SDLLABS/LoonIntercom/docs/images/intercom-render.jpg

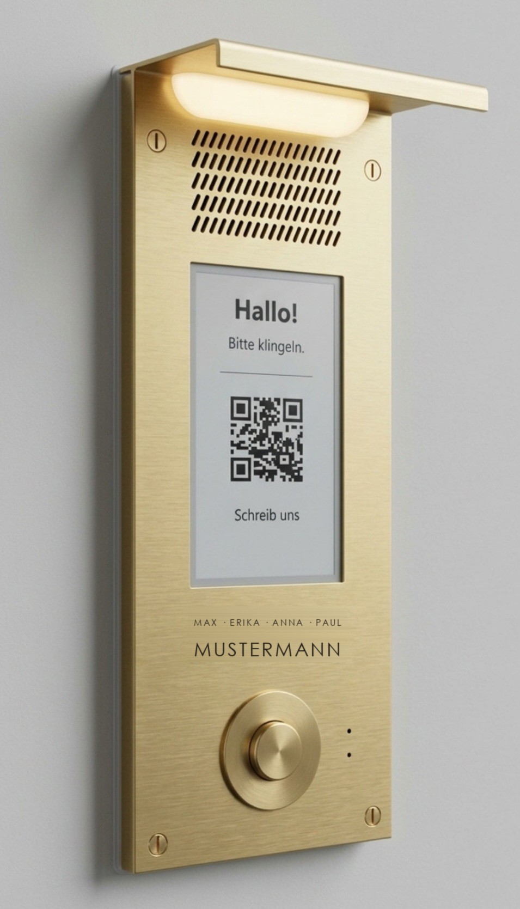
docs/images/intercom-render.jpg
