SDLLABS/LoonIntercom/hardware/access-controller/README.md

# Indoor controller hardware gates

No board, schematic or actuator is selected by WP4. All switching and strike/gate power paths must stay in a protected indoor enclosure. No outdoor conductor may energize an actuator when shorted. A P4-connected keypad remains an observable convenience input; a possible high-assurance keypad needs a separate protected connection directly to the indoor controller.

Before connecting a real actuator, select and verify: protected indoor resource-to-actuator and timing profiles; default-off drive for **every** relay and boot/reset/brownout pull state; an **independent** maximum-on cutoff that drops output after its armed bound even if MCU firmware stalls; a `force_cutoff_off` path that physically removes actuator power even when relay-off fails; a `force_relays_off` path for all outputs; fail-secure polarity and power behavior; door contact plus held-open/forced-open sensing; protected REX and egress/fire compliance; key storage and provisioning; tamper response that cannot unlock; surge/power isolation. Production pulse/cutoff values remain unselected. A welded relay contact may bypass an electrical cutoff and needs separate hazard review. The software API callbacks are contracts, not evidence of such circuitry.
