SDLLABS/LoonIntercom/firmware/access-controller/README.md

# Indoor access controller skeleton

`access_core.c` is a portable, allocation-free verifier, attempt limiter and relay state machine for WP4. It contains no board-specific relay pin, network listener, credential database or secret. `access_core.h` defines adapters that a future protected indoor MCU implementation must provide. Protected indoor policy maps each authenticated resource ID to an actuator ID and pulse/cutoff profile; the credential adapter must check that resource's scope. The `force_cutoff_off` adapter must force the independent power cutoff safe even if the relay driver cannot deassert; `force_relays_off` must de-energize every output at boot/fault. Neither may bypass or disable the safety cutoff. Until then this is **host-testable design code, not deployable access-control firmware**.

Run `make test` for the host tests. The test harness uses OpenSSL only to model a HMAC provider; the product crypto/transport adapter is not selected. The core requires a trusted authenticated confidential-channel assertion and a per-principal MAC verifier. It cannot be called safely from a raw UDP/MQTT handler. The caller must wipe sensitive receive buffers after dispatch, ensure transport identity equals `principal_id`, and serialize controller calls.

The P4 keypad path is restricted to scoped convenience credentials. A higher-assurance keypad needs its own protected direct path indoors. No keypad hardware is selected. The transport must supply its authenticated peer ID to both core entry points; the core checks that a request frame names the same principal. See [protocol](../../protocol/access.md) and [hardware gates](../../hardware/access-controller/README.md).

The host test's 250 ms pulse and 500 ms cutoff are illustrative skeleton profile values, not production settings. Compile-time ceilings and runtime profile checks reject unsafe values, but hardware must independently enforce maximum-on. A one-time credential is consumed by the indoor adapter upon authorization before hardware actuation; a later hardware failure does not refund it or prove door movement.

## SMS one-time-code path (ADR-0005)

`sms_parse.c` strictly parses an `ABRIR <resource> <code>` body, `sms_otp.c` computes and verifies LSMS1 counter-based codes (HMAC-SHA-256 bound to resource and command, 20-value look-ahead, constant-time), and `ac_handle_sms()` applies the same attempt limit, lockout, busy and actuator-profile checks as ACR1 before the code is checked, so refused attempts never consume a counter. The `verify_sms_otp` callback is optional; `NULL` disables the path. The adapter must map an allowlisted sender to an `AC_PRINCIPAL_GSM` principal and persist `matched + 1` before returning true. See [protocol/sms-access.md](../../protocol/sms-access.md) and `tools/loon_sms.py` for the phone side.
