SDLLABS/LoonIntercom/docs/upstream-map.md

# Upstream feature and provenance map

Snapshot: 2026-10-01. Inspected local SDLLABS branch `3e56b7d5cda3cb52aa66ff9235040faf1f77c6e9`, remote [SDLLABS `main`](https://github.com/SDLLABS/intercom/tree/77b56da677b08da73ba137dddba78e8834585f59) and [Aikos `main`](https://github.com/aikos-home/intercom/tree/77b56da677b08da73ba137dddba78e8834585f59) at the same commit, and [OpenChime `main`](https://github.com/exddc/openchime/tree/8085381252216dccae1ad18aaa766daee0c03c6c). Remote heads were checked with `git ls-remote`; OpenChime was shallow-cloned to a temporary directory for inspection. This map distinguishes implemented code from specifications and proposals. No OpenChime source was imported.

| Feature or lesson | Current source and evidence | Current maturity | SDLLABS treatment |
| --- | --- | --- | --- |
| Supervised physical button, 1 ms ADC sampling intent, hysteresis, press identity, cable-cut/short diagnostics, maximum ring duration | [Aikos bell core](https://github.com/aikos-home/intercom/blob/77b56da677b08da73ba137dddba78e8834585f59/firmware/bell/bell-core.yaml); [bench notes](https://github.com/aikos-home/intercom/blob/77b56da677b08da73ba137dddba78e8834585f59/firmware/bell/README.md) | Implemented in inherited ESPHome configuration; bench results documented, not re-tested in WP1 | Preserve in `firmware/bell/`; regression gate for later changes. |
| Direct RoomKey ring: encrypted UDP `packet_transport`, rolling code, `(boot_id, presses)` identity, `ringing` state, unicast targets | [Bell core](https://github.com/aikos-home/intercom/blob/77b56da677b08da73ba137dddba78e8834585f59/firmware/bell/bell-core.yaml), [S3 board config](https://github.com/aikos-home/intercom/blob/77b56da677b08da73ba137dddba78e8834585f59/firmware/bell/s3poeeth-intercom-bell.yaml), [bell README](https://github.com/aikos-home/intercom/blob/77b56da677b08da73ba137dddba78e8834585f59/firmware/bell/README.md) | Implemented bell sender; RoomKey receiver belongs to separate Aikos project and was not inspected here | Keep direct path and test with RoomKey later. HA API remains secondary and has `reboot_timeout: 0s`, `batch_delay: 0ms`. |
| E-paper/touch UI and partial-refresh driver | [Screen firmware](https://github.com/aikos-home/intercom/tree/77b56da677b08da73ba137dddba78e8834585f59/firmware/screen), [screen README](https://github.com/aikos-home/intercom/blob/77b56da677b08da73ba137dddba78e8834585f59/firmware/screen/README.md) | Bench-tested inherited screen subsystem; driver states LilyGo/ESPHome provenance and C/C++ GPLv3, Python MIT | Retain as separate failure domain. Review compatibility and licenses before integrating into a new image. |
| PoE, surge, heater fail-cold, environmental/mechanical design and power governor | [Inherited architecture](https://github.com/aikos-home/intercom/blob/77b56da677b08da73ba137dddba78e8834585f59/docs/architecture.md), [hardware tree](https://github.com/aikos-home/intercom/tree/77b56da677b08da73ba137dddba78e8834585f59/hardware) | Mixed: documented design, components/bench work, and unverified installation choices | Preserve safety rules; recompute P4 power/thermal margin rather than assuming existing PoE budget covers camera/audio. |
| Chime MQTT-to-audio service, reconnect/heartbeat, independent HTTPS setup daemon | [OpenChime Chime README](https://github.com/exddc/openchime/blob/8085381252216dccae1ad18aaa766daee0c03c6c/chime/README.md), [source tree](https://github.com/exddc/openchime/tree/8085381252216dccae1ad18aaa766daee0c03c6c/chime) | Implemented for Pi Zero W and Linux, with host tests; depends on broker for Chime ring | Learn service/config separation and observability. Do not replace Aikos direct RoomKey path with broker-dependent Chime. |
| Product/platform/board dependency direction, bounded process work, separate configuration runtime | [OpenChime platform README](https://github.com/exddc/openchime/blob/8085381252216dccae1ad18aaa766daee0c03c6c/platform/README.md) | Implemented C++/CMake structure with Linux/POSIX services | Adapt the interface-boundary principle to ESP-IDF components; do not copy POSIX runners, filesystem/HTTP server infrastructure by default. |
| WebRTC, Opus, hardware H.264, full duplex/AEC and MQTT signaling | [OpenChime Ring variant requirements](https://github.com/exddc/openchime/blob/8085381252216dccae1ad18aaa766daee0c03c6c/hardware/ring/variants/rpi02w_cm3/README.md) | **Specification only in current Ring tree** (`ring/README.md` is a placeholder); Pi hardware assumptions differ from P4 | WP3 feasibility study, then select ESP-IDF-compatible implementations. No assertion that OpenChime provides portable working media code. |
| Signed command plus nonce; BLE challenge/counter; Ring MQTT status/press topics | [OpenChime Ring variant requirements](https://github.com/exddc/openchime/blob/8085381252216dccae1ad18aaa766daee0c03c6c/hardware/ring/variants/rpi02w_cm3/README.md) | Ring interface requirement, not an implemented, reviewed access protocol | Borrow threat questions only. WP4 designs a separate indoor-verifying protocol; no outdoor relay command topic. |
| Outdoor strike/gate relays and Pi/SD/Buildroot image | [OpenChime Ring wiring/interface](https://github.com/exddc/openchime/blob/8085381252216dccae1ad18aaa766daee0c03c6c/hardware/ring/variants/rpi02w_cm3/README.md), [Buildroot tree](https://github.com/exddc/openchime/tree/8085381252216dccae1ad18aaa766daee0c03c6c/buildroot) | Ring hardware design and implemented Chime Linux image/OTA model | Explicitly reject relay placement, Pi drivers, Buildroot, SD boot/rootfs. Adapt only rollback and runbook ideas to NOR/ESP-IDF. |
| Local-only operation and hardware documentation discipline | [OpenChime README](https://github.com/exddc/openchime/blob/8085381252216dccae1ad18aaa766daee0c03c6c/README.md), [Ring hardware README](https://github.com/exddc/openchime/blob/8085381252216dccae1ad18aaa766daee0c03c6c/hardware/ring/README.md) | Project design/documentation | Use as engineering references, with SDLLABS trust and power boundaries. |

## Target silicon evidence

Espressif's [ESP32-P4 Series datasheet, section 4.2.1](https://www.espressif.com/sites/default/files/documentation/esp32-p4_datasheet_en.pdf) documents a Baseline H.264 hardware encoder with maximum 1080p30 performance for YUV420 input, plus MIPI-CSI and an ISP. This is an established SoC capability, not an OpenChime port or proof that a selected board, sensor/driver, PSRAM, NOR, Ethernet/PoE and audio combination works. WP2 validates those board paths and capture/encode; WP3 evaluates complete streams, RTSP/WebRTC, Opus/AEC, latency and memory/CPU/network budgets.

## Provenance and license rules

The current SDLLABS `main` remains at the Aikos commit above; this branch adds handoff/architecture material and WP1 docs. Existing Aikos bell and screen code stays in place. OpenChime is [MIT licensed](https://github.com/exddc/openchime/blob/8085381252216dccae1ad18aaa766daee0c03c6c/LICENSE); no code was copied for WP1. A future port must record upstream repository, commit, source path, copied/adapted files, modification summary, and applicable copyright/license notices in the change and retain the MIT notice where required. Third-party code nested inside OpenChime needs its own license audit. The existing screen driver has separate [license information](https://github.com/aikos-home/intercom/blob/77b56da677b08da73ba137dddba78e8834585f59/firmware/screen/components/lilygo_t5_47_plus/LICENSE).

## Baseline reconciliation

The inherited `docs/architecture.md` says the ring goes to HA first and rules out cameras. Those statements describe an earlier Aikos product concept. The current bell implementation sends a direct RoomKey packet independently of HA, and SDLLABS v2 adds a separate P4 camera subsystem while leaving the bell path intact. Do not rewrite the inherited historical document as evidence of v2 implementation. See [architecture v2](architecture-v2.md) and its ADRs for the adopted direction.
