SDLLABS/LoonIntercom/docs/images/explorer.png

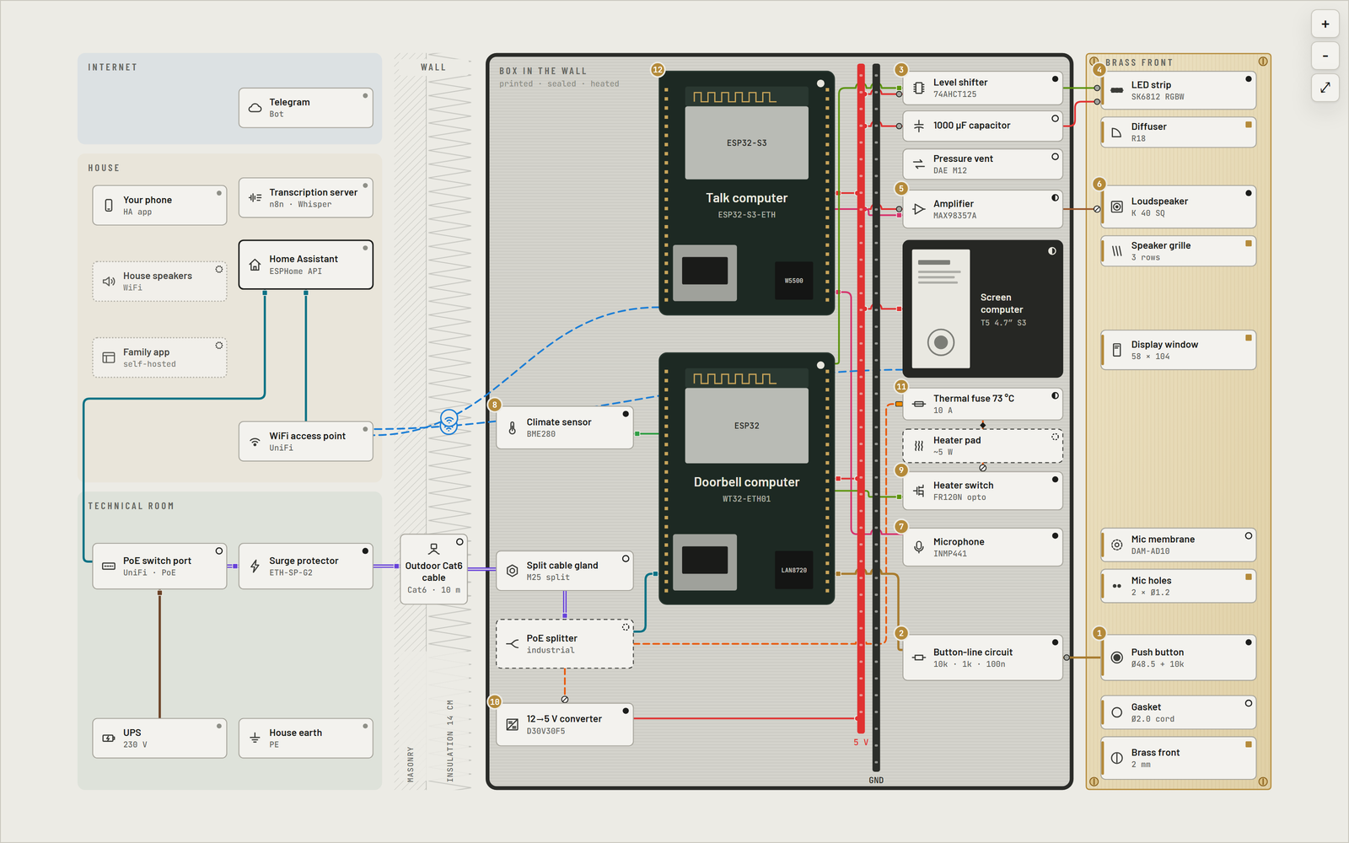
docs/images/explorer.png
