SDLLABS/LoonIntercom/firmware/screen/demo-assets/bell.gif

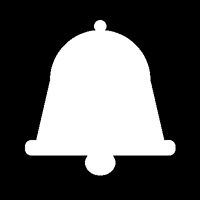
firmware/screen/demo-assets/bell.gif
