SDLLABS/LoonIntercom/firmware/screen/demo-assets/front.png

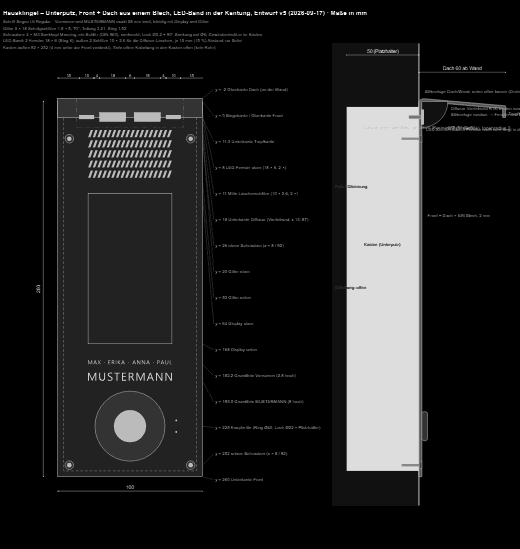
firmware/screen/demo-assets/front.png
