SDLLABS/LoonIntercom/hardware/front-sheet/detail-kantung-v5.png

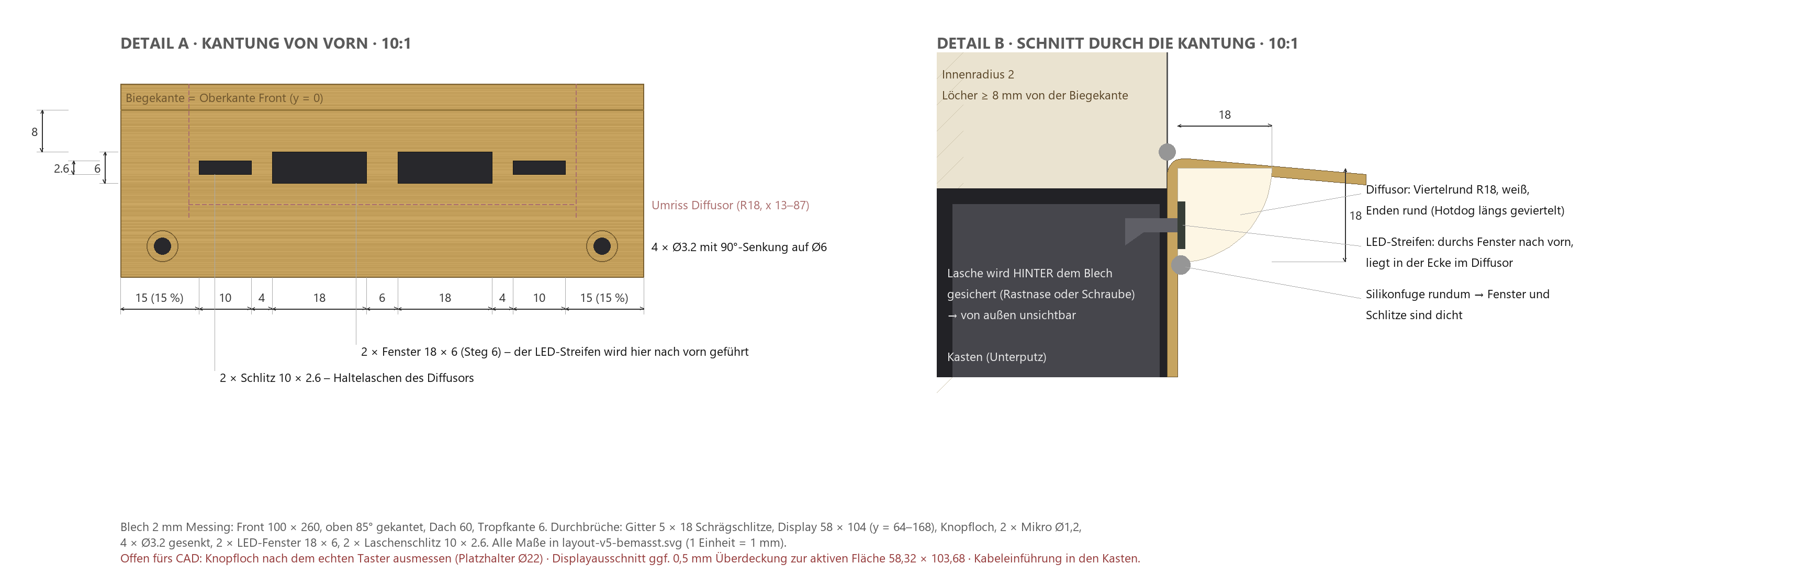
hardware/front-sheet/detail-kantung-v5.png
