SDLLABS/LoonIntercom/hardware/front-sheet/gemini-zeichnung-v5.png

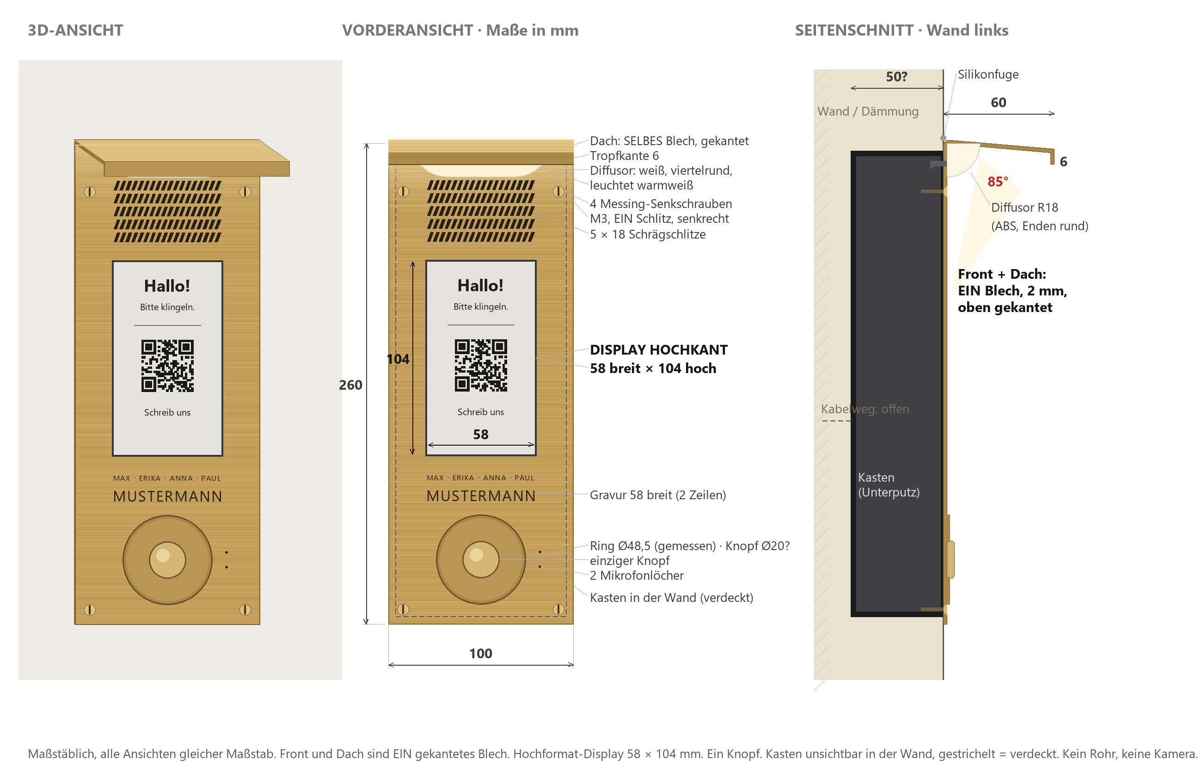
hardware/front-sheet/gemini-zeichnung-v5.png
