SDLLABS/LoonIntercom/hardware/front-sheet/layout-v5-referenz.png

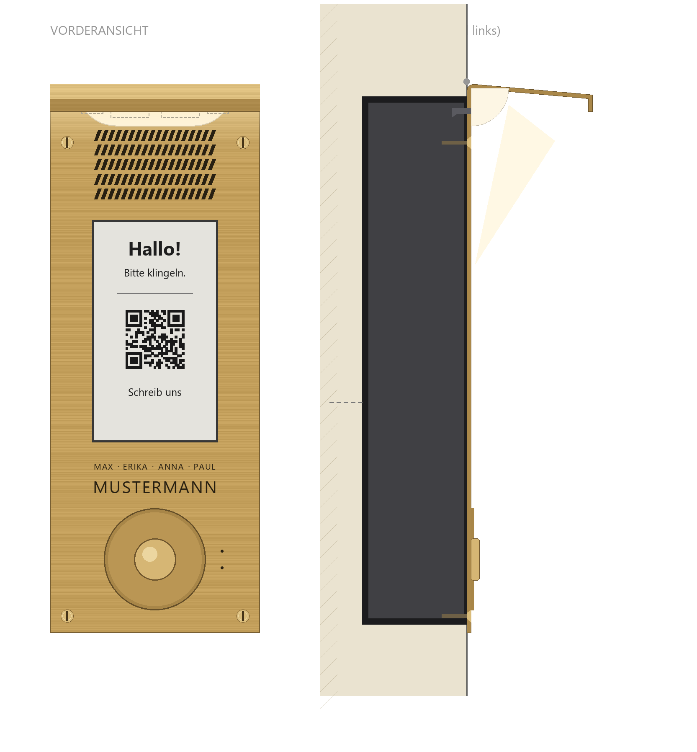
hardware/front-sheet/layout-v5-referenz.png
