SDLLABS/LoonIntercom/hardware/parts/display-panel.png

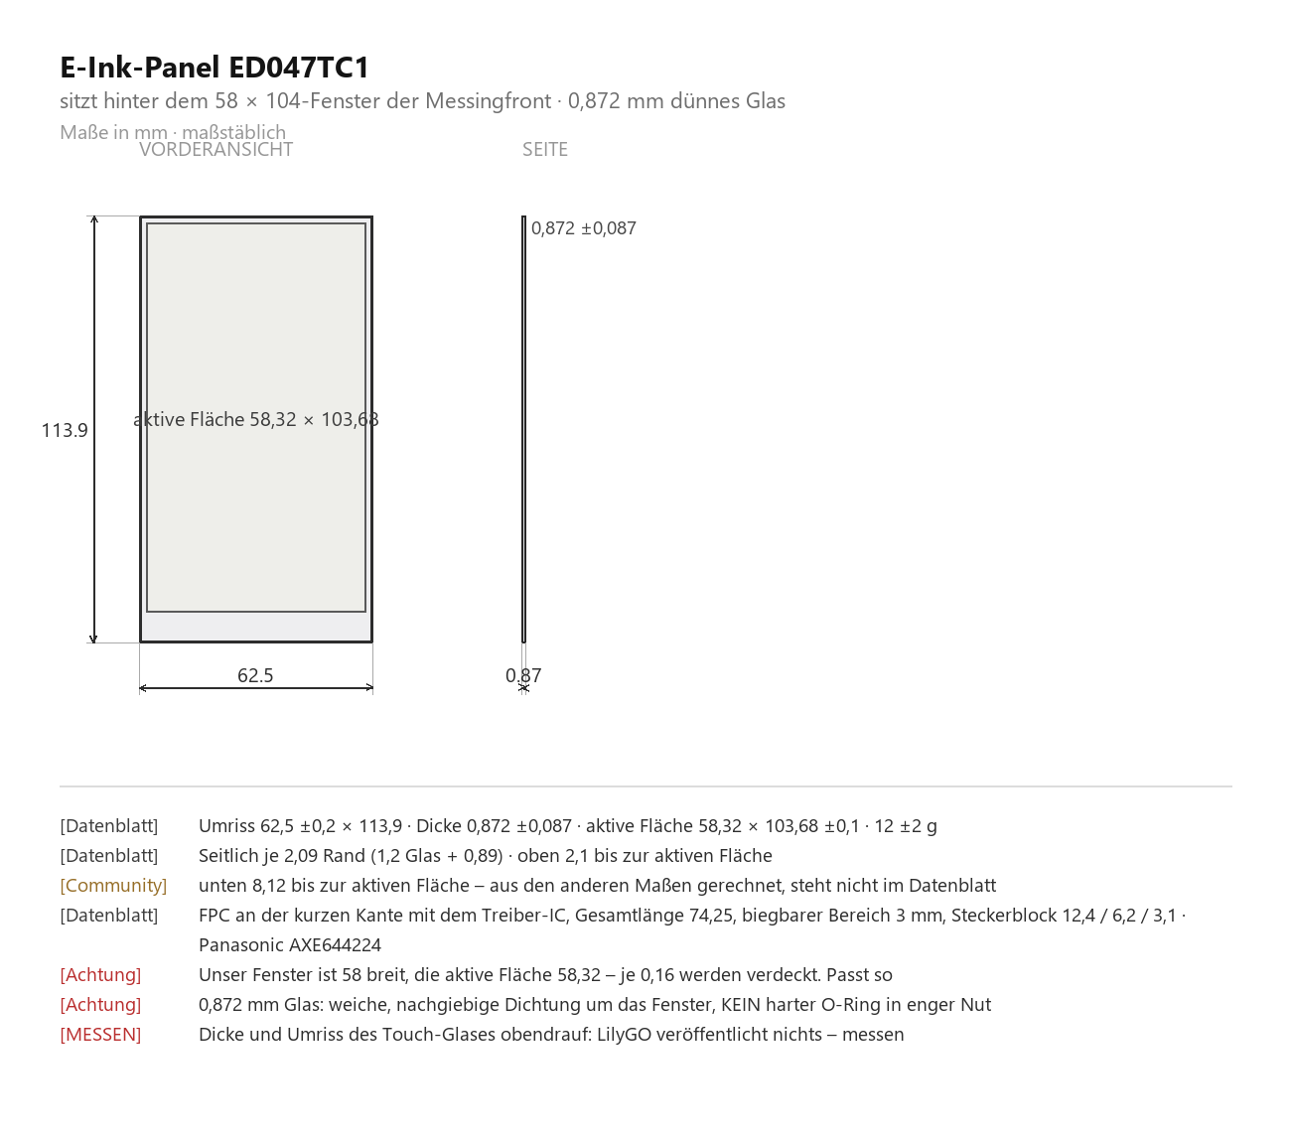
hardware/parts/display-panel.png
