SDLLABS/LoonIntercom/hardware/parts/display-pcb.png

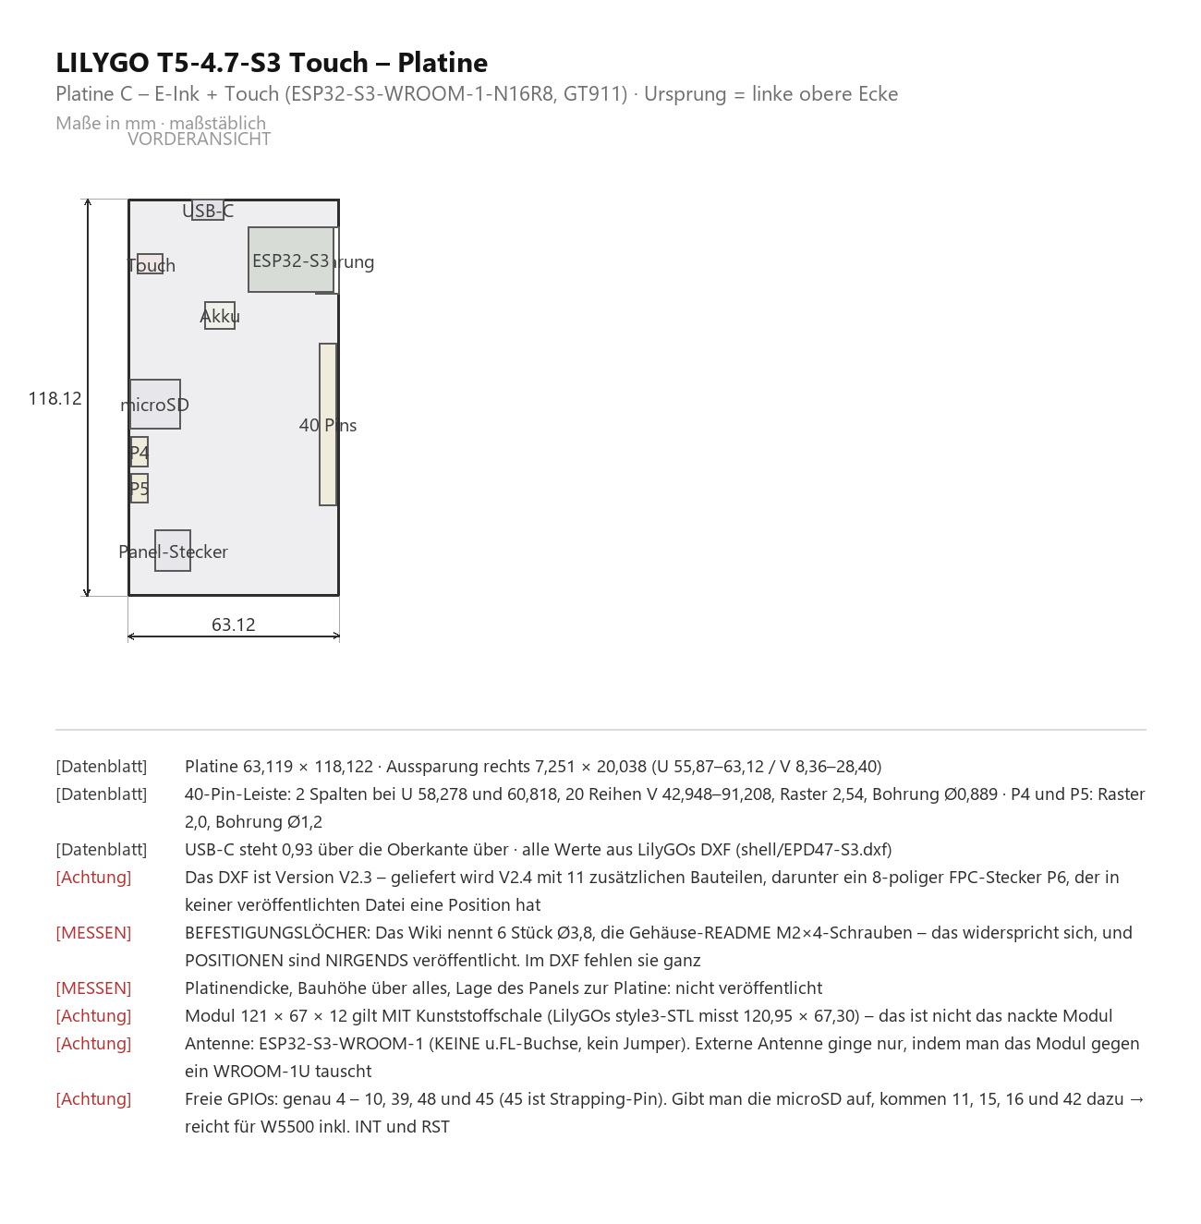
hardware/parts/display-pcb.png
