SDLLABS/LoonIntercom/hardware/parts/heizpad.png

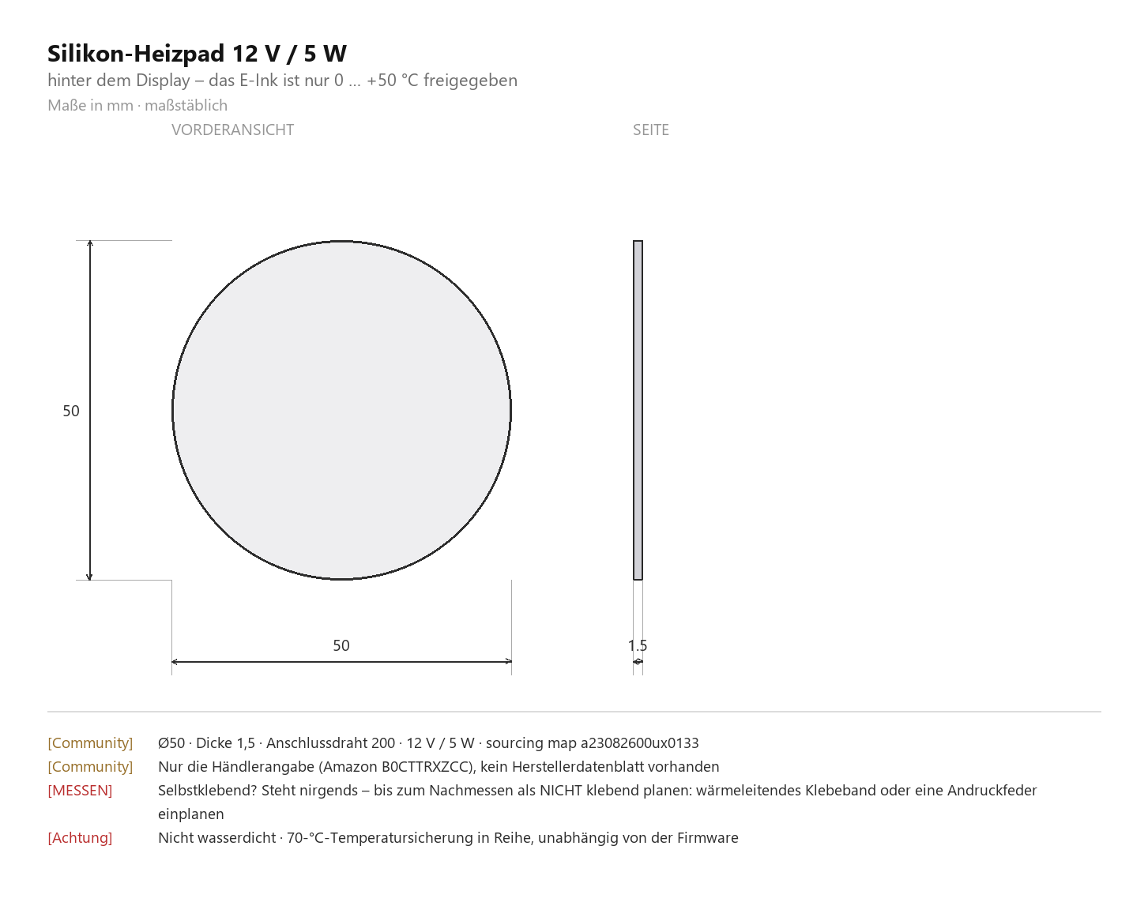
hardware/parts/heizpad.png
