SDLLABS/LoonIntercom/hardware/parts/inmp441.png

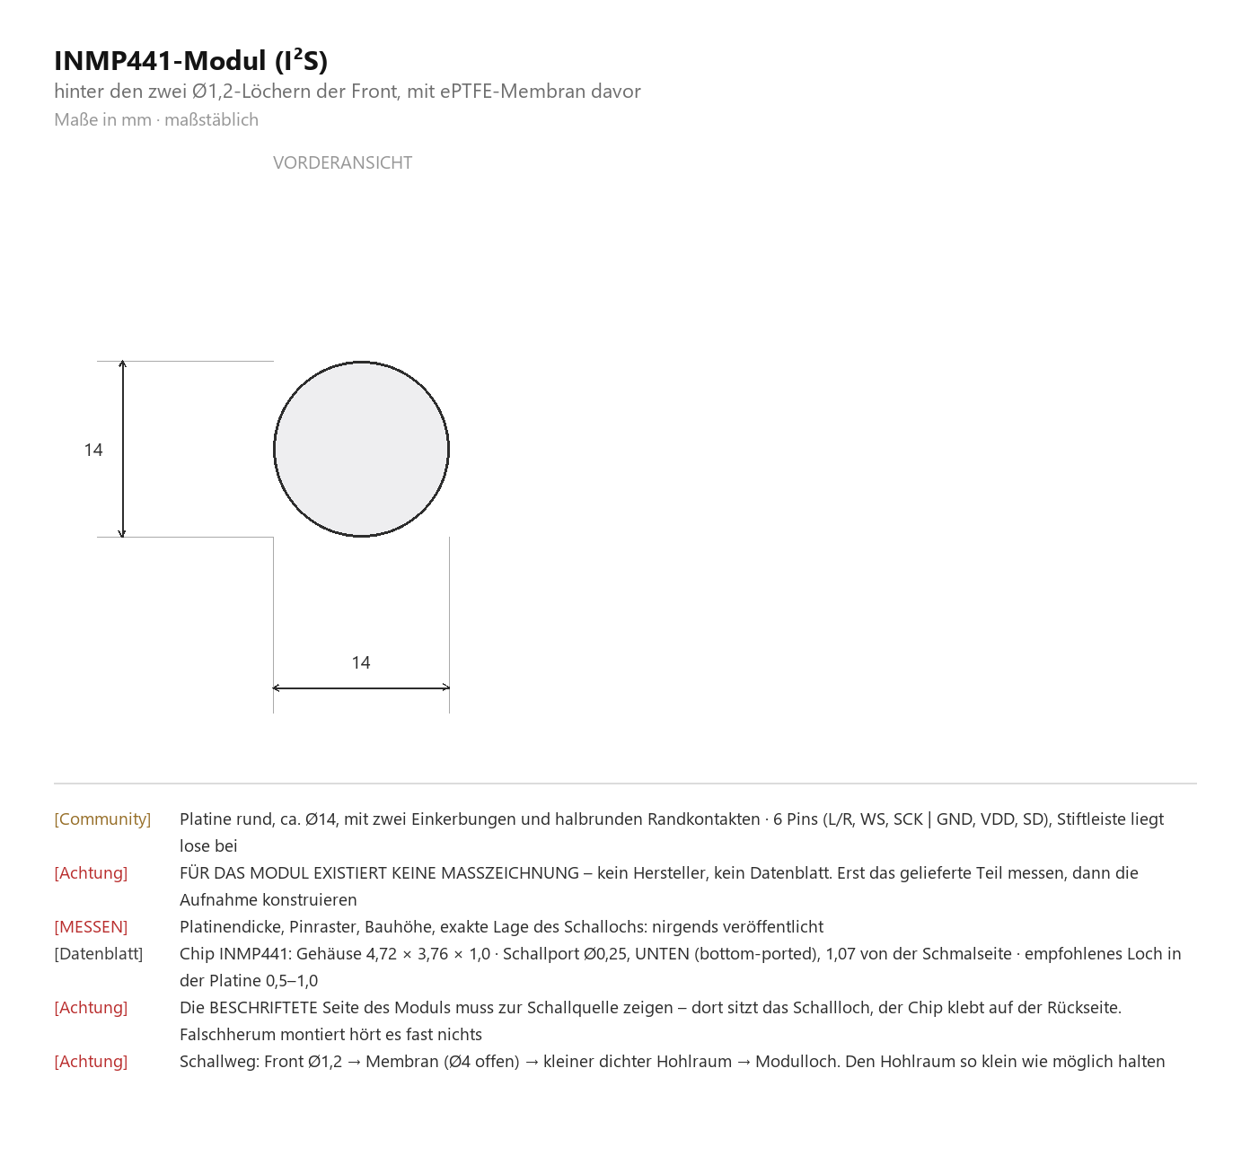
hardware/parts/inmp441.png
