SDLLABS/LoonIntercom/hardware/parts/max98357a.png

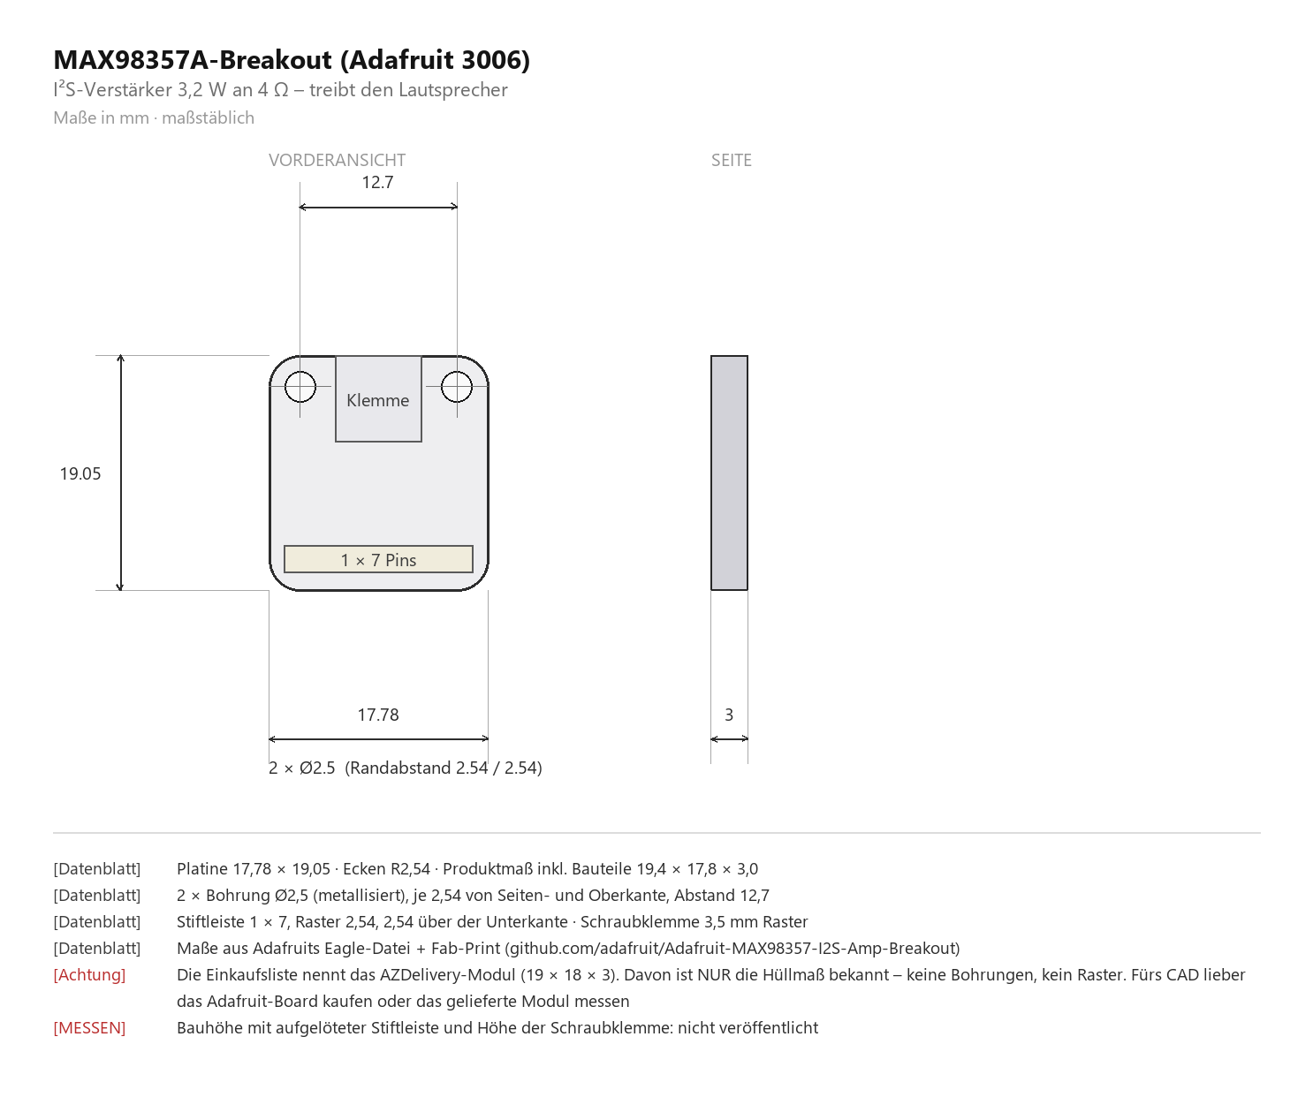
hardware/parts/max98357a.png
