SDLLABS/LoonIntercom/hardware/parts/membran-ip67.png

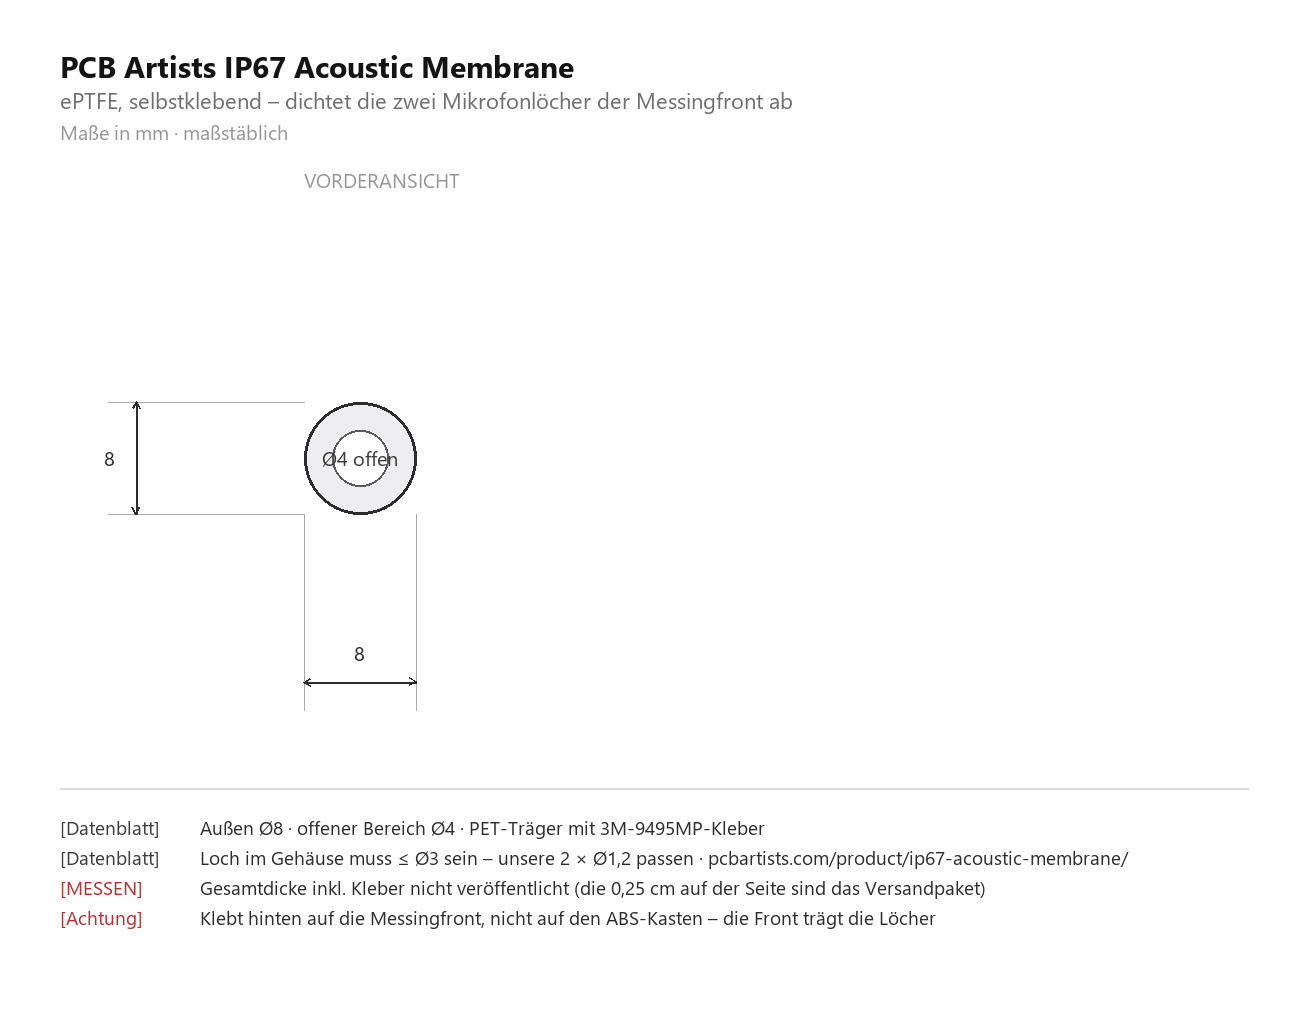
hardware/parts/membran-ip67.png
