SDLLABS/LoonIntercom/hardware/models/diffuser-v1_print.stl

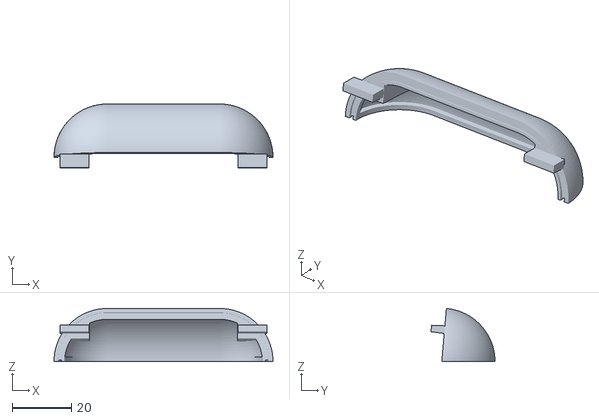
[picture p21: CAD file, 2026-10-01]
hardware/models/diffuser-v1_print.stl
74.0 x 21.6 x 17.9
