SDLLABS/LoonIntercom/hardware/models/diffuser-test-plate.stl

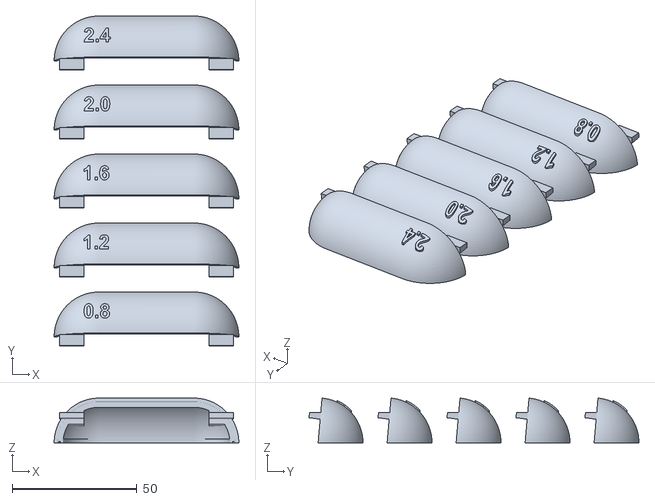
[picture p22: CAD file, 2026-10-01]
hardware/models/diffuser-test-plate.stl
74.0 x 132.2 x 17.9
