SDLLABS/LoonIntercom/hardware/models/front-sheet-v5_print_front.stl

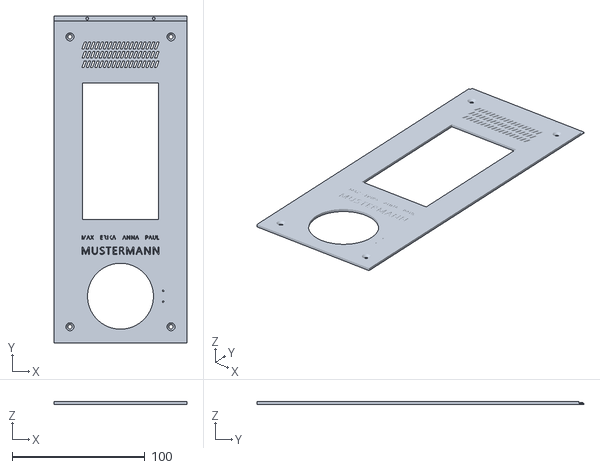
[picture p23: CAD file, 2026-10-01]
hardware/models/front-sheet-v5_print_front.stl
100.0 x 245.5 x 2.00
