SDLLABS/LoonIntercom/hardware/models/box-v3_print.stl

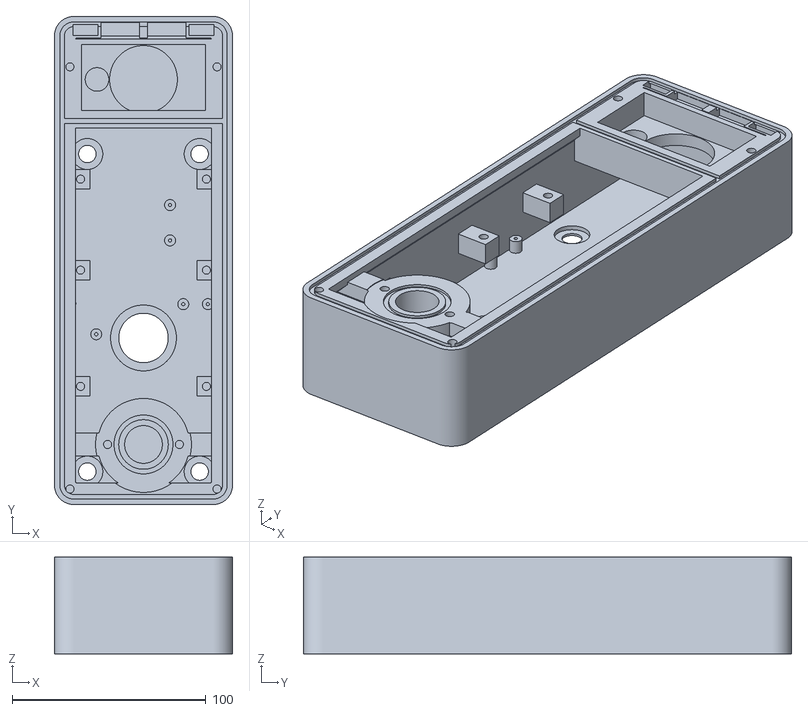
[picture p24: CAD file, 2026-10-01]
hardware/models/box-v3_print.stl
92.0 x 252.0 x 50.0
