SDLLABS/LoonIntercom/hardware/models/front-sheet-v5_print_roof.stl

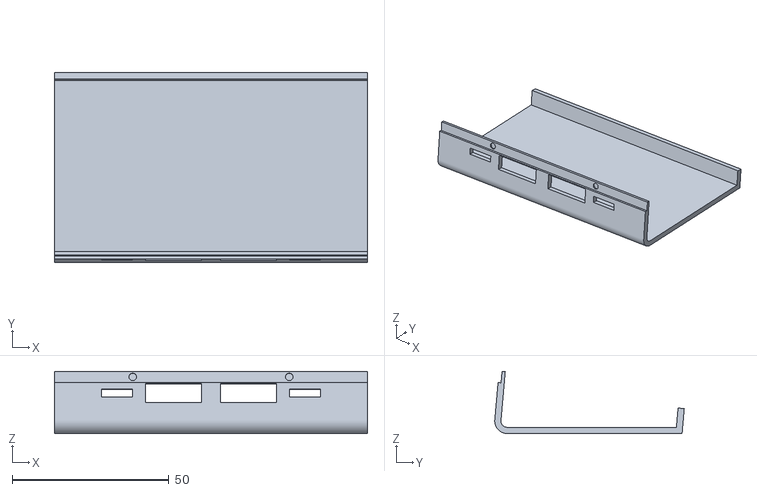
[picture p25: CAD file, 2026-10-01]
hardware/models/front-sheet-v5_print_roof.stl
100.0 x 60.6 x 19.8
