SDLLABS/LoonIntercom/hardware/models/carrier-plate-v3_print.stl

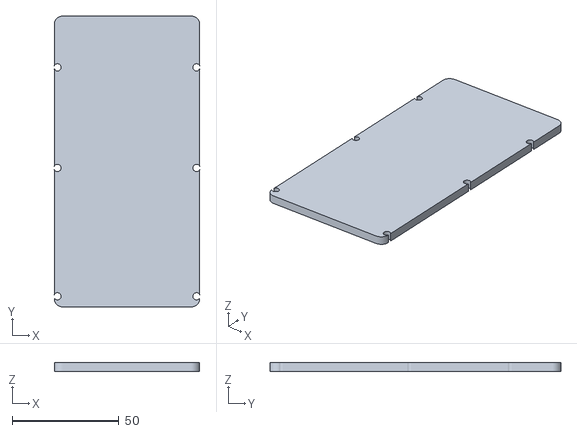
[picture p26: CAD file, 2026-10-01]
hardware/models/carrier-plate-v3_print.stl
68.0 x 136.0 x 4.00
