SDLLABS/LoonIntercom/hardware/models/front-sheet-v5.step

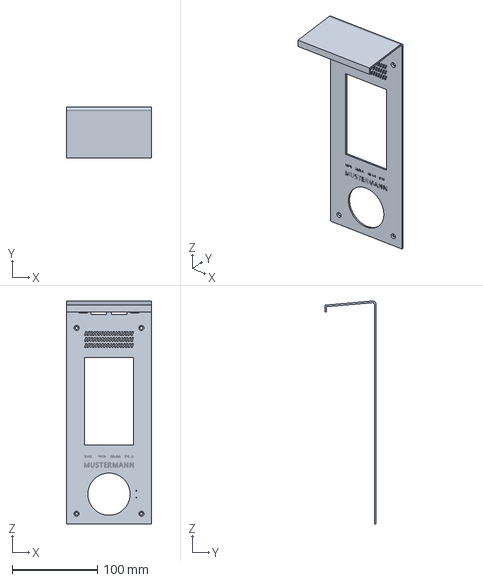
[picture p27: CAD file, 2026-10-01]
hardware/models/front-sheet-v5.step
100.0 x 60.0 x 261.6 mm
