SDLLABS/LoonIntercom/(list of files, cad)

Other CAD files:
hardware/models/diffuser-v1.step
hardware/models/front-sheet-v5_print.stl
