SDLLABS/LoonIntercom/firmware/p4/components/board_support/board_support.c

#include <stdint.h>
#include "esp_chip_info.h"
#include "esp_flash.h"
#include "freertos/FreeRTOS.h"
#include "freertos/semphr.h"
#include "esp_heap_caps.h"
#include "esp_log.h"
#include "esp_psram.h"
#include "esp_system.h"
#include "sdkconfig.h"
#include "board_support.h"

static const char *TAG = "board_support";

#if CONFIG_P4_BOARD_FUNCTION_EV_V152
extern const struct p4_board_config p4_function_ev_v152;
#elif CONFIG_P4_BOARD_WAVESHARE_ESP32_P4_ETH_32086
extern const struct p4_board_config p4_waveshare_esp32_p4_eth_32086;
#else
#error "Select and implement a P4 board profile before building"
#endif

const struct p4_board_config *p4_board_get(void)
{
#if CONFIG_P4_BOARD_FUNCTION_EV_V152
    return &p4_function_ev_v152;
#else
    return &p4_waveshare_esp32_p4_eth_32086;
#endif
}

void p4_board_report_memory(void)
{
    const struct p4_board_config *board = p4_board_get();
    esp_chip_info_t chip = {0};
    esp_chip_info(&chip);
    ESP_LOGI(TAG, "detected chip revision: %d", chip.revision);
    uint32_t flash_bytes = 0;
    esp_err_t err = esp_flash_get_size(NULL, &flash_bytes);
    if (err == ESP_OK) {
        ESP_LOGI(TAG, "detected NOR flash: %lu bytes", (unsigned long)flash_bytes);
        if (board->expected_nor_bytes && flash_bytes != board->expected_nor_bytes) {
            ESP_LOGW(TAG, "NOR capacity differs from board profile (%lu bytes)",
                     (unsigned long)board->expected_nor_bytes);
        }
    } else {
        ESP_LOGE(TAG, "NOR flash size query failed: %s", esp_err_to_name(err));
    }
    size_t psram_bytes = esp_psram_get_size();
    ESP_LOGI(TAG, "detected PSRAM: %lu bytes", (unsigned long)psram_bytes);
    if (board->expected_psram_bytes) {
        if (psram_bytes != board->expected_psram_bytes) {
            ESP_LOGW(TAG, "PSRAM capacity differs from board profile (%lu bytes)",
                     (unsigned long)board->expected_psram_bytes);
        }
    }
    ESP_LOGI(TAG, "ESP-IDF available PSRAM heap: %lu bytes",
             (unsigned long)heap_caps_get_total_size(MALLOC_CAP_SPIRAM));
    ESP_LOGI(TAG, "available PSRAM heap is not a physical-capacity or memory stress test");
}

esp_err_t p4_board_i2c_bus(i2c_master_bus_handle_t *out)
{
    static i2c_master_bus_handle_t s_bus;
    static portMUX_TYPE s_lock = portMUX_INITIALIZER_UNLOCKED;
    static SemaphoreHandle_t s_init_mutex;
    if (out == NULL) return ESP_ERR_INVALID_ARG;

    taskENTER_CRITICAL(&s_lock);
    if (s_init_mutex == NULL) {
        static StaticSemaphore_t storage;
        s_init_mutex = xSemaphoreCreateMutexStatic(&storage);
    }
    taskEXIT_CRITICAL(&s_lock);

    xSemaphoreTake(s_init_mutex, portMAX_DELAY);
    esp_err_t err = ESP_OK;
    if (s_bus == NULL) {
        const struct p4_i2c_config *i2c = &p4_board_get()->i2c;
        i2c_master_bus_config_t config = {
            .clk_source = I2C_CLK_SRC_DEFAULT,
            .i2c_port = i2c->port,
            .sda_io_num = i2c->sda_gpio,
            .scl_io_num = i2c->scl_gpio,
            .glitch_ignore_cnt = 7,
            .flags.enable_internal_pullup = true,
        };
        err = i2c_new_master_bus(&config, &s_bus);
        if (err != ESP_OK) {
            s_bus = NULL;
            ESP_LOGE(TAG, "shared I2C bus init failed: %s", esp_err_to_name(err));
        }
    }
    *out = s_bus;
    xSemaphoreGive(s_init_mutex);
    return err;
}
