SDLLABS/LoonIntercom/(commit log)

2026-10-01 Initial SDLLABS Intercom architecture
    [box-v3_print.stl, carrier-plate-v3_print.stl, diffuser-test-plate.stl, diffuser-v1.step, diffuser-v1_print.stl, front-sheet-v5.step, front-sheet-v5_print.stl, front-sheet-v5_print_front.stl]
2026-10-07 access: SMS one-time-code entry path via indoor GSM modem (ADR-0005)
    Adds LSMS1: counter-based HMAC-SHA-256 one-time codes bound to resource
    and command, a strict SMS body parser, and ac_handle_sms() for a new
    AC_PRINCIPAL_GSM principal that reuses the existing rate limit, lockout,
    busy and actuator-profile checks before any code is consumed. Includes
    the phone-side generator tools/loon_sms.py (stdlib only; a-Shell/Termux),
    cross-checked test vectors, ADR-0005 and protocol/sms-access.md.
    Claude-Session: https://claude.ai/code/session_0165JHQur5NXY9ms9o3bqXvz
2026-10-07 p4: fix first ESP-IDF v5.5.4 build of the bring-up project
    The project had never been built. Two defects stopped it:
    - board_support/CMakeLists.txt raised FATAL_ERROR during ESP-IDF's early
    requirement-expansion pass, where Kconfig values are not yet defined.
    The board-profile checks now run only in the real build pass.
    - board_support.c used esp_chip_info() without esp_chip_info.h, which
    esp_system.h no longer includes in v5.5.
    Function-EV default and Waveshare (pre-v3 and v3.1 overlays) now build
    with ESP-IDF v5.5.4. Not flashed or run on hardware.
    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
    [board_support.c]
2026-10-07 p4: OV5647 camera capture smoke with JPEG snapshot over HTTP (WP2.2)
    - board_support: p4_board_i2c_bus() creates the internal I2C bus once and
    shares it (probe, camera SCCB, later codec); camera descriptor gains
    reset/power-down GPIOs and SCCB speed. Waveshare SCCB shares GPIO7/8
    with ES8311; adds an OV5647 presence probe at 0x36.
    - peripheral_smoke uses the shared bus instead of creating/deleting one.
    - camera_smoke (Kconfig P4_CAMERA_SMOKE, default off): esp_video init on
    the shared bus, sensor chip ID, ISP RGB565 1080p streaming with frame,
    error and fps counters; optional unauthenticated bench HTTP server with
    /status and /snapshot.jpg (hardware JPEG, bounded 2 s). Failure is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
    [board_support.c, board_support.h, camera_smoke.c, function_ev_v152.c, main.c, peripheral_smoke.c, waveshare_esp32_p4_eth_32086.c]
